Doom4535/ENGR-357-Project/Schematics/CDCE925/PW0016A.stp

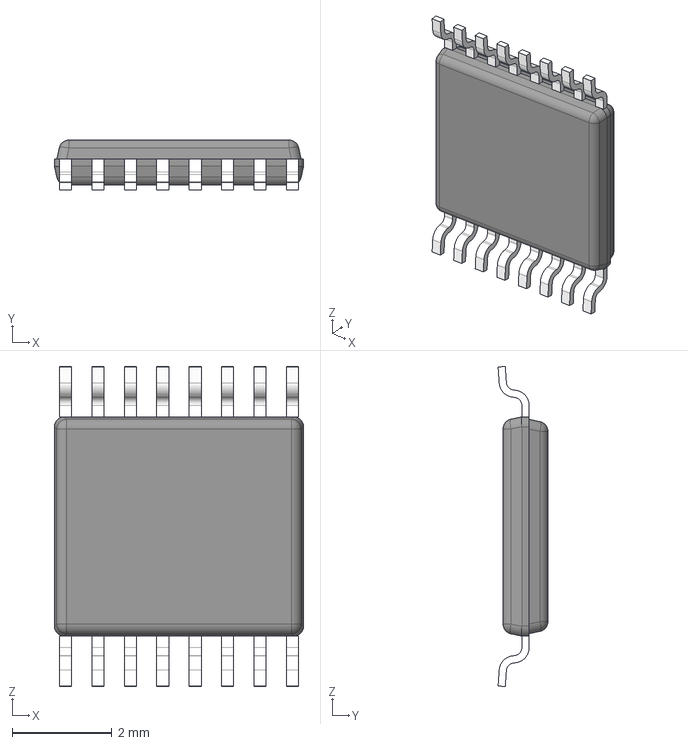
[picture p1: CAD file, 2016-04-19]
Schematics/CDCE925/PW0016A.stp
5.00 x 1.00 x 6.42 mm
BODY_MTC16
LEAD_MTC16 x 16
