Doom4535/ENGR-357-Project/Schematics/TS3A5018/D0016A.stp

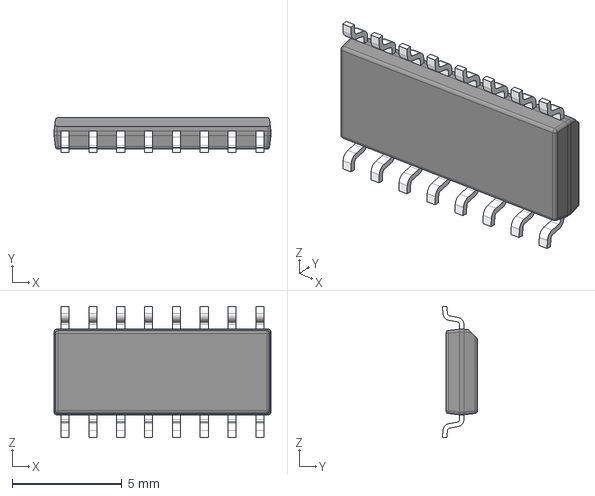
[picture p2: CAD file, 2016-04-19]
Schematics/TS3A5018/D0016A.stp
9.91 x 1.60 x 5.99 mm
BODY_M16A_17
LEAD_M16A_42 x 16
