Doom4535/ENGR-357-Project/PDFs/revised_engr_357.pdf

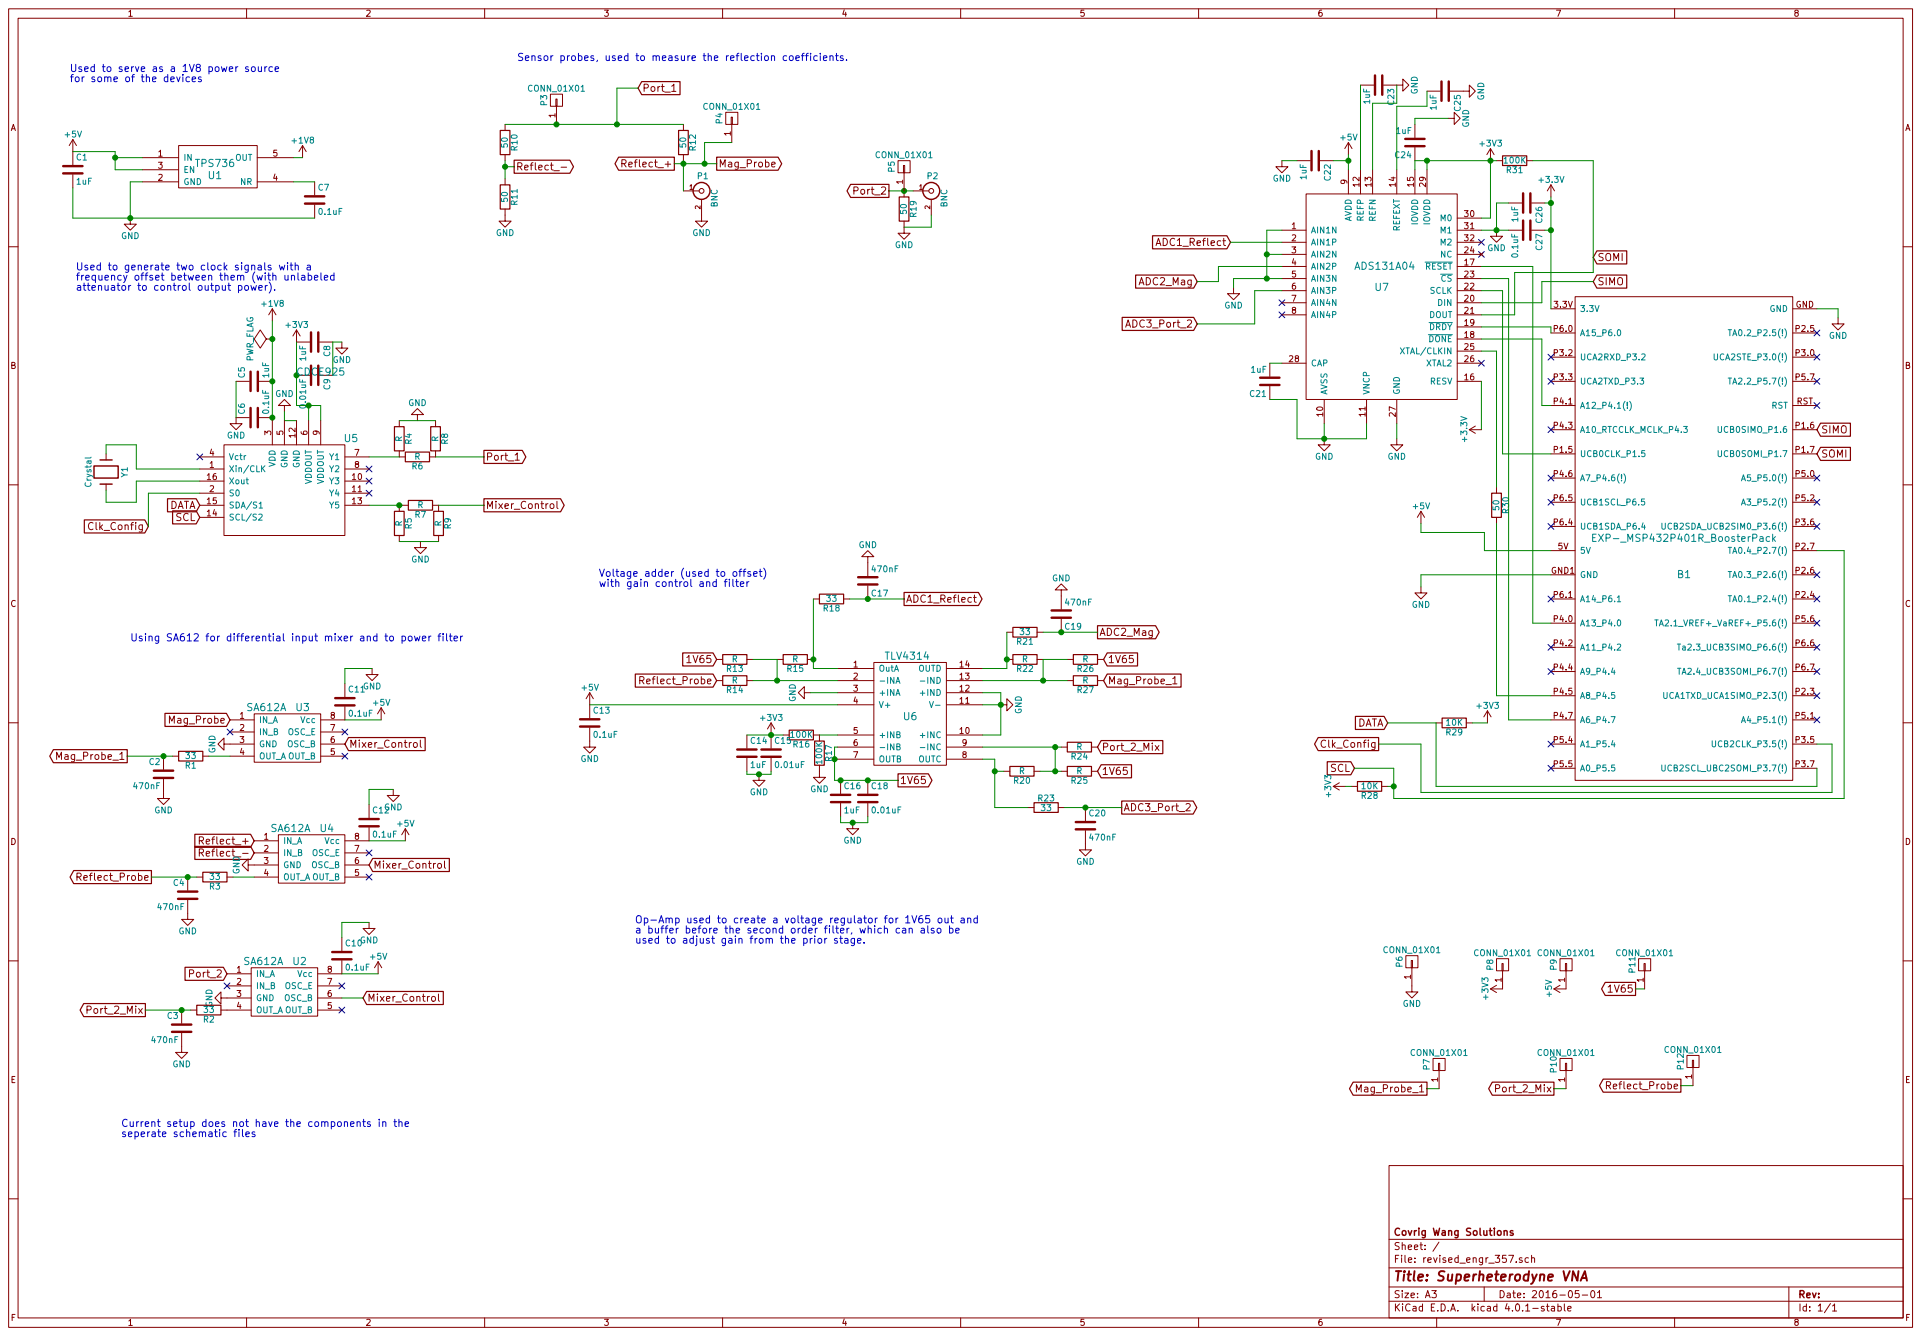
[picture p3: page 1]

Used to serve as a 1V8 power source

9 AVSS 10 DIN 20 M0 30 VNCP 11 DOUT 21 M1 31 REFP 12 SCLK 22 M2 32 REFN 13 CS 23 REFEXT 14 NC 24 IOVDD 15 XTAL/CLKIN 25 RESV 16 XTAL2 26 RESET 17 GND 27 DONE 18 CAP 28 DRDY 19 IOVDD 29 U7 ADS131A04 +3.3V

Used to generate two clock signals with a
frequency offset between them (with unlabeled
attenuator to control output power).

9 Y3 10 Y4 11 GND 12 Y5 13 SCL/S2 14 SDA/S1 15 Xout 16 U5 CDCE925 GND

Using SA612 for differential input mixer and to power filter

1uF Op-Amp used to create a voltage regulator for 1V65 out and

a buffer before the second order filter, which can also be
used to adjust gain from the prior stage.

Current setup does not have the components in the
seperate schematic files

File: revised_engr_357.sch Sheet: / Covrig Wang Solutions

Id: 1/1 Title: Superheterodyne VNA
