Doom4535/ENGR-357-Project/PDFs/VNA.pdf

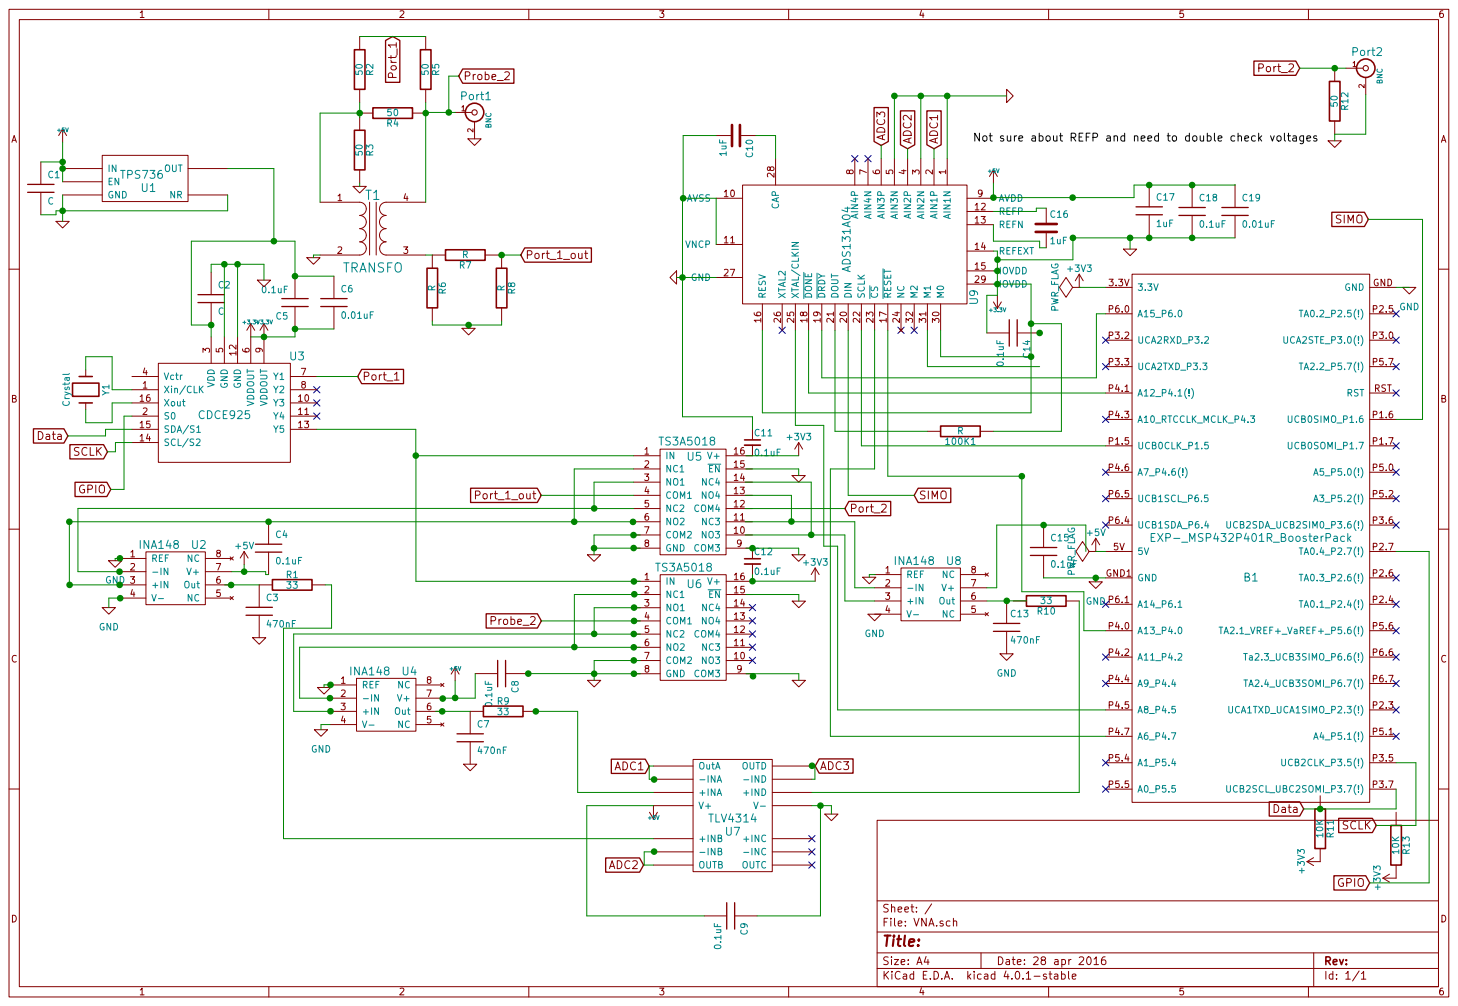
[picture p4: page 1]

8 AVDD 9 AVSS 10 DIN 20 M0 30 VNCP 11 DOUT 21 M1 31 REFP 12 SCLK 22 M2 32 REFN 13 CS 23 REFEXT 14 NC 24

9 Y3 10 Y4 11 GND 12 Y5 13 SCL/S2 14 SDA/S1 15 Xout 16 U3 CDCE925

Id: 1/1 Title: File: VNA.sch Sheet: /
