Doom4535/ENGR-357-Project/(list of files, drawings)

Other design files:
Project_2/revised_engr_357.dsn
