Doom4535/ENGR-357-Project/Project_2/revised_engr_357.kicad_pcb

## KiCad design Project_2/revised_engr_357.kicad_pcb (2016-06-07)

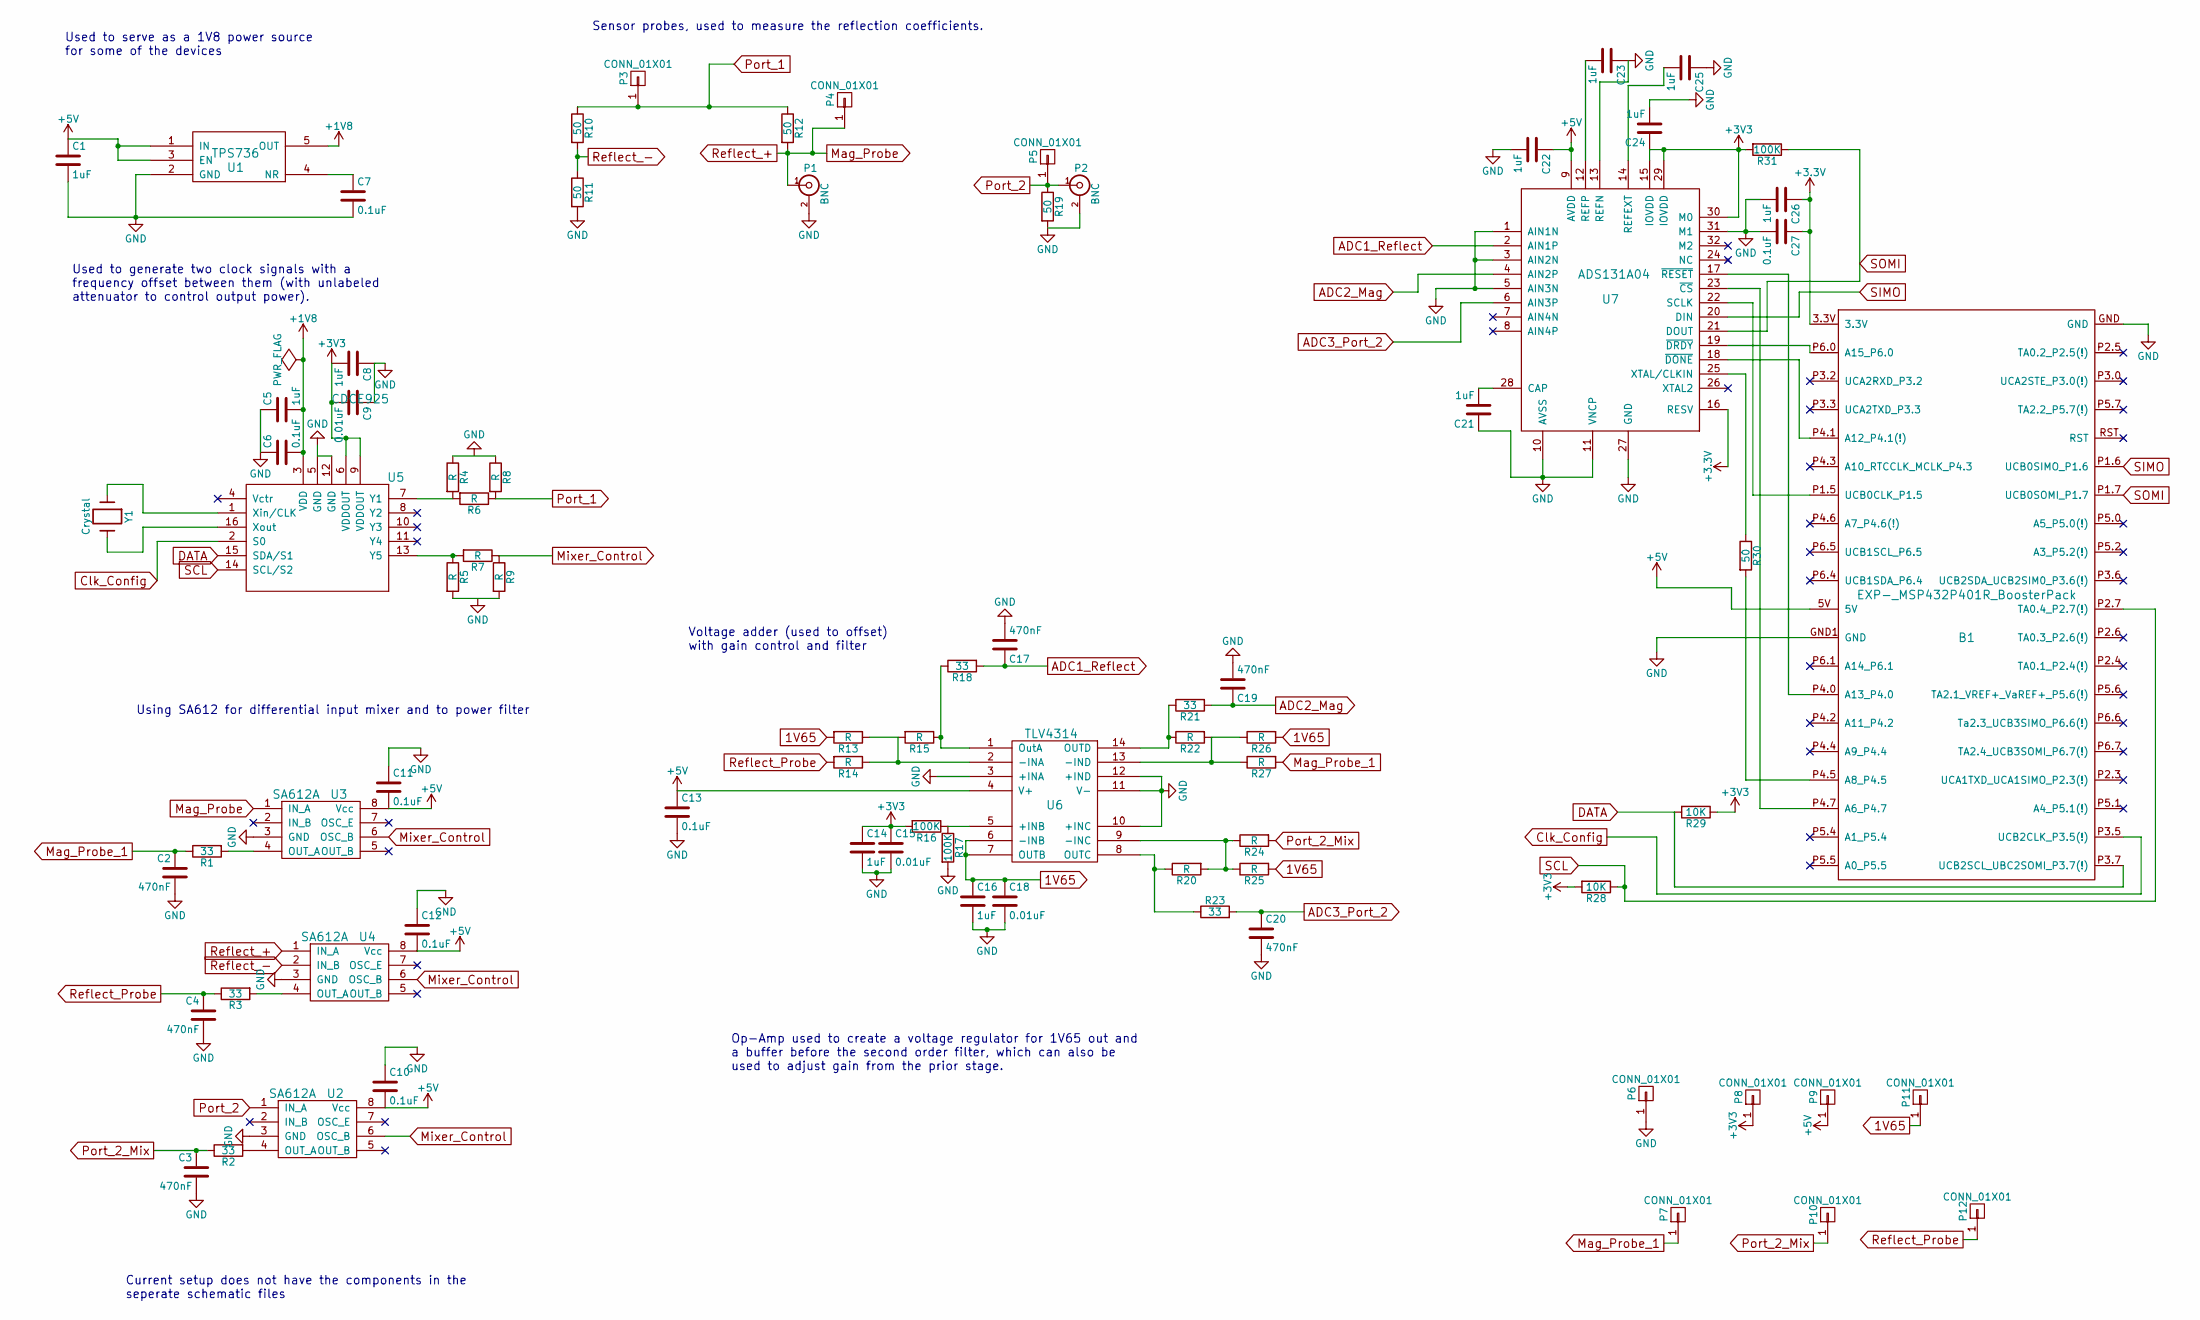
[picture p5: schematic revised_engr_357.sch, Superheterodyne VNA]

Parts:
B1: EXP-_MSP432P401R_BoosterPack; TI_BoosterPack
C1, C5, C8, C14, C16, C21, C22, C23, C24, C25, C26: 1uF; C_0805
C2, C3, C4, C17, C19, C20: 470nF; C_0805
C6, C7, C10, C11, C12, C13, C27: 0.1uF; C_0805
C9, C15, C18: 0.01uF; C_0805
P1, P2: BNC; BNC_Socket_TYCO-AMP
P3, P4, P5, P6, P7, P8, P9, P10, P11, P12: CONN_01X01; Measurement_Point_Round-SMD-Pad_Small
R1, R2, R3, R18, R21, R23: 33; R_0805
R4, R5, R6, R7, R8, R9, R13, R14, R15, R20, R22, R24, R25, R26, R27: R; R_0805
R10, R11, R12, R19, R30: 50; R_0805
R16, R17, R31: 100K; R_0805
R28, R29: 10K; R_0805
U1: TPS736; SOT-23-5
U2, U3, U4: SA612A; SO-8
U5: CDCE925; TSSOP-16_4.4x5mm_Pitch0.65mm
U6: TLV4314; TSSOP-14_4.4x5mm_Pitch0.65mm
U7: ADS131A04; LQFP-32_5x5mm_Pitch0.5mm
Y1: Crystal; Crystal_SMD_2520_4Pads

Connections:
1V65: C16.1, C18.1, P11.1, R13.2, R25.2, R26.2, U6.6 (-INB), U6.7 (OUTB)
+1V8: C5.2, C6.2, U1.5 (OUT), U5.3 (VDD)
+5V: B1.5V, C1.1, C10.2, C11.2, C12.2, C13.1, C22.1, P9.1, U1.1 (IN), U1.3 (EN), U2.8 (Vcc), U3.8 (Vcc), U4.8 (Vcc), U6.4 (V+), U7.9 (AVDD)
ADC1_Reflect: C17.1, R18.2, U7.2 (AIN1P)
ADC2_Mag: C19.1, R21.2, U7.4 (AIN2P)
ADC3_Port_2: C20.1, R23.2, U7.6 (AIN3P)
Clk_Config: B1.P3.5 (UCB2CLK_P3.5(!)), U5.2 (S0)
DATA: B1.P3.7 (UCB2SCL_UBC2SOMI_P3.7(!)), R29.2, U5.15 (SDA/S1)
Mag_Probe: P1.1 (In), P4.1, R12.2, U3.1 (IN_A), U4.1 (IN_A)
Mag_Probe_1: C2.1, P7.1, R1.1, R27.2
Mixer_Control: R7.1, R9.1, U2.6 (OSC_B), U3.6 (OSC_B), U4.6 (OSC_B)
unnamed: B1.P1.5 (UCB0CLK_P1.5), U7.22 (SCLK)
unnamed: B1.P4.0 (A13_P4.0), U7.17 (~RESET)
unnamed: B1.P4.1 (A12_P4.1(!)), U7.18 (~DONE)
unnamed: B1.P4.5 (A8_P4.5), R30.2
unnamed: B1.P4.7 (A6_P4.7), U7.23 (~CS)
unnamed: B1.P6.0 (A15_P6.0), U7.19 (~DRDY)
unnamed: C7.1, U1.4 (NR)
unnamed: C21.2, U7.28 (CAP)
unnamed: C23.2, U7.12 (REFP)
unnamed: C25.2, U7.14 (REFEXT)
unnamed: R1.2, U3.4 (OUT_A)
unnamed: R2.2, U2.4 (OUT_A)
unnamed: R3.2, U4.4 (OUT_A)
unnamed: R4.2, R6.2, U5.7 (Y1)
unnamed: R5.1, R7.2, U5.13 (Y5)
unnamed: R13.1, R14.1, R15.2, U6.2 (-INA)
unnamed: R15.1, R18.1, U6.1 (OutA)
unnamed: R16.1, R17.1, U6.5 (+INB)
unnamed: R20.1, R23.1, U6.8 (OUTC)
unnamed: R20.2, R24.1, R25.1, U6.9 (-INC)
unnamed: R21.1, R22.1, U6.14 (OUTD)
unnamed: R22.2, R26.1, R27.1, U6.13 (-IND)
unnamed: R30.1, U7.25 (XTAL/CLKIN)
unnamed: U5.1 (Xin/CLK), Y1.1
unnamed: U5.16 (Xout), Y1.2
Port_1: P3.1, R6.1, R8.2, R10.1, R12.1
Port_2: P2.1 (In), P5.1, R19.1, U2.1 (IN_A)
Port_2_Mix: C3.1, P10.1, R2.1, R24.2
Reflect_-: R10.2, R11.1, U4.2 (IN_B)
Reflect_Probe: C4.1, P12.1, R3.1, R14.2
SCL: B1.P2.7 (TA0.4_P2.7(!)), R28.1, U5.14 (SCL/S2)
SIMO: B1.P1.6 (UCB0SIMO_P1.6), U7.20 (DIN)
SOMI: B1.P1.7 (UCB0SOMI_P1.7), R31.1, U7.21 (DOUT)

Notes on the sheet:
Op-Amp used to create a voltage regulator for 1V65 out and a buffer before the second order filter, which can also be used to adjust gain from the prior stage.
Using SA612 for differential input mixer and to power filter
Used to generate two clock signals with a frequency offset between them (with unlabeled attenuator to control output power).
Used to serve as a 1V8 power source for some of the devices
Sensor probes, used to measure the reflection coefficients.
Current setup does not have the components in the seperate schematic files
Voltage adder (used to offset) with gain control and filter

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
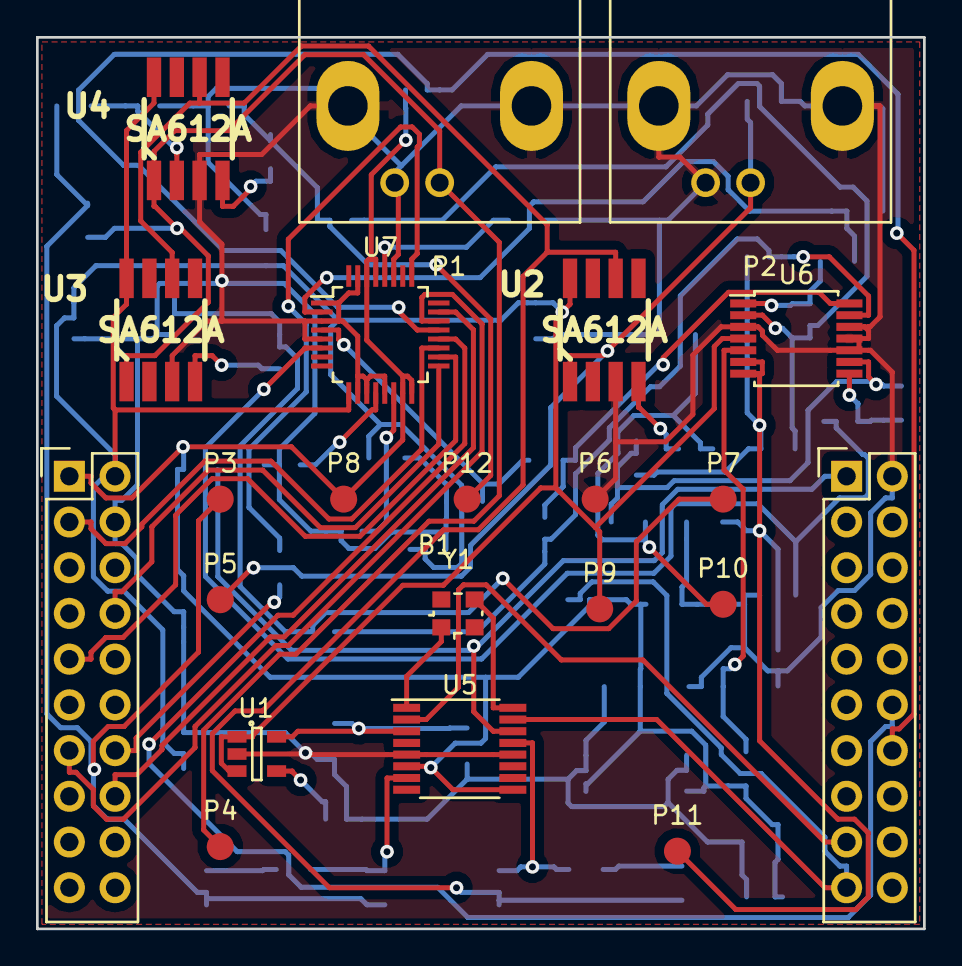
[picture p6: board revised_engr_357.kicad_pcb from above]

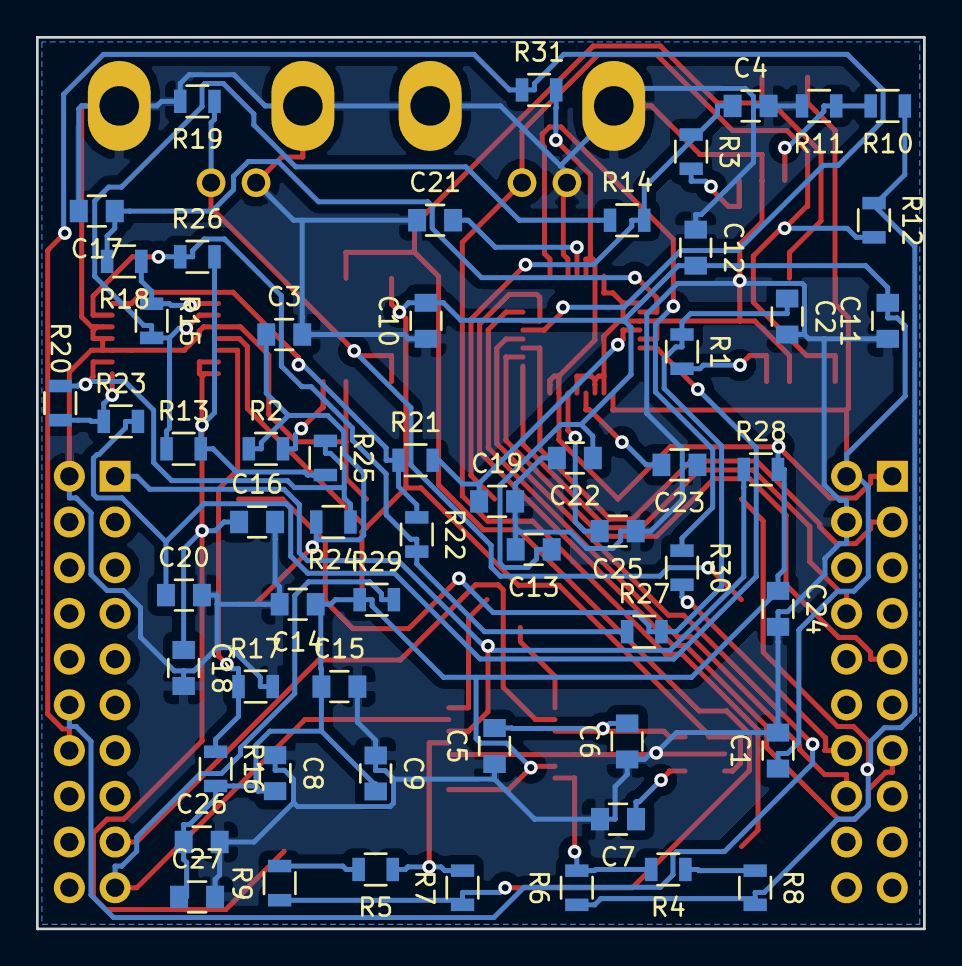
[picture p7: board revised_engr_357.kicad_pcb from below]

Board: 2 copper layers, 49.3 x 49.5 mm, 79 parts (58 on the bottom side), 48 nets.
