Doom4535/ENGR-357-Project/Schematics/content/enforced/279243-ENGR357-S16/2016_VNA.kicad_pcb

## KiCad design Schematics/content/enforced/279243-ENGR357-S16/2016_VNA.kicad_pcb (2016-04-29)

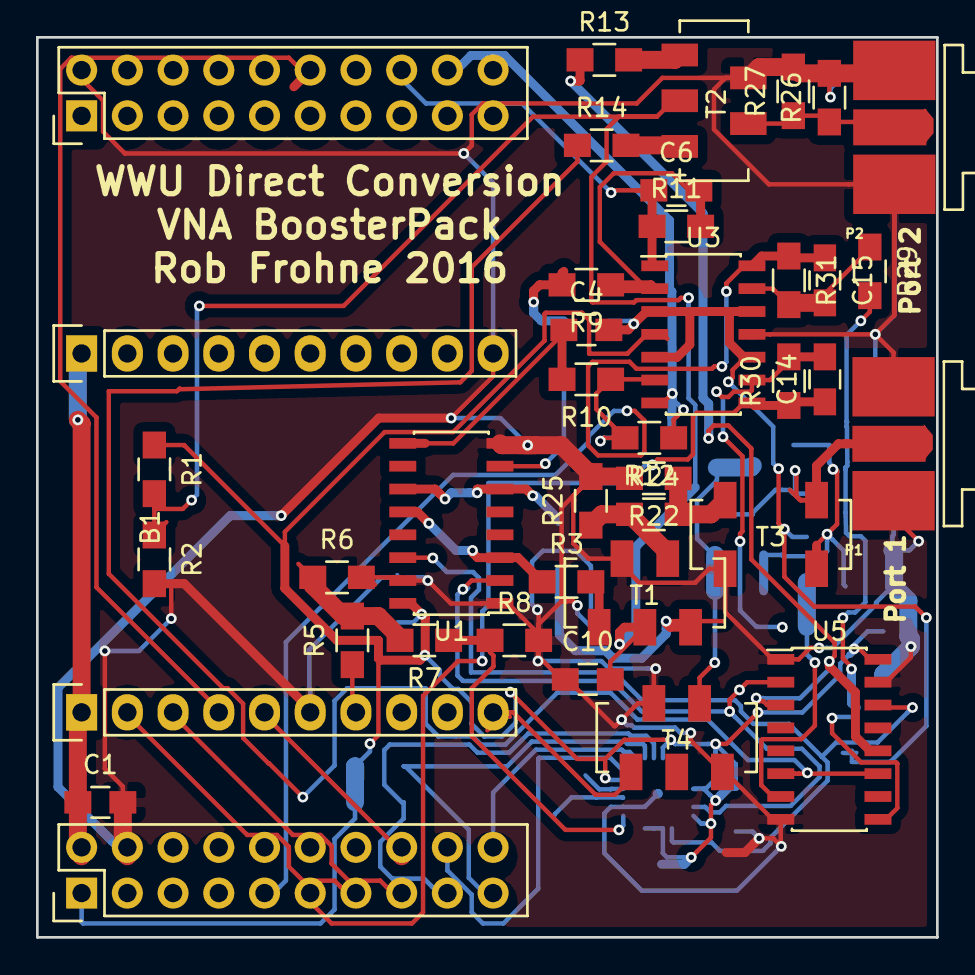
[picture p8: board 2016_VNA.kicad_pcb from above]

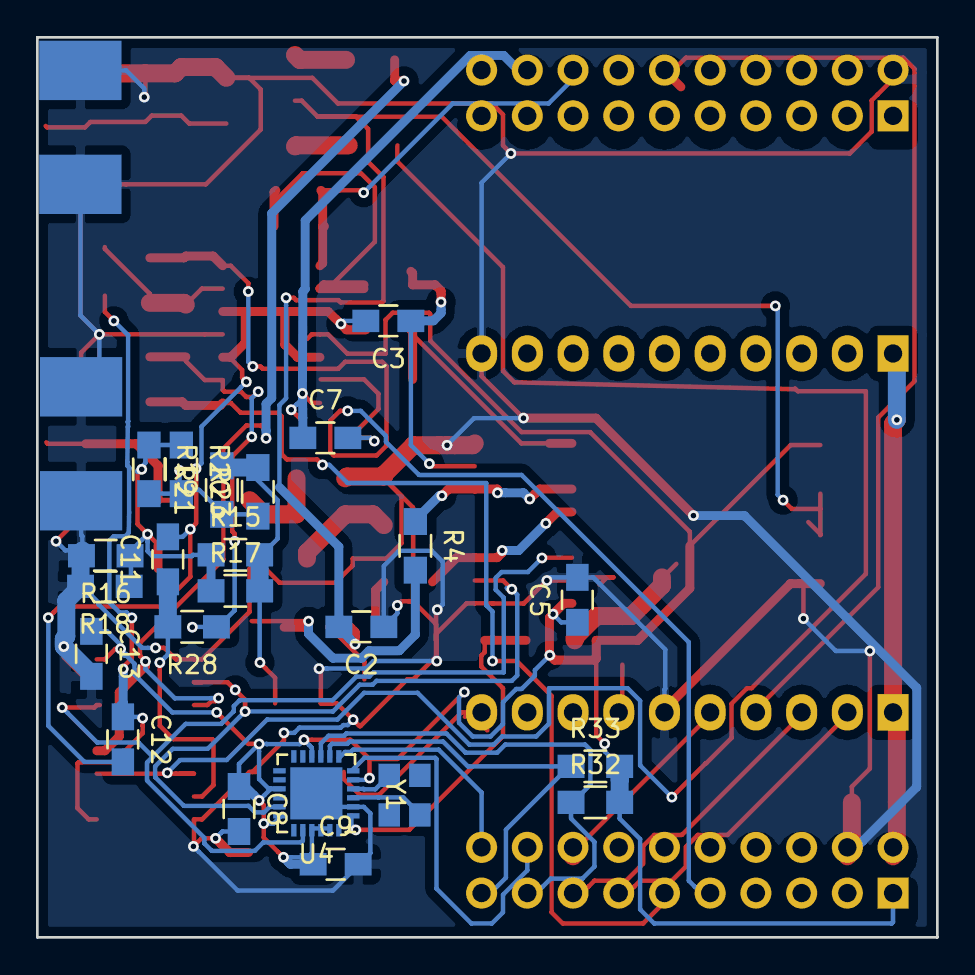
[picture p9: board 2016_VNA.kicad_pcb from below]

Board: 2 copper layers, 50.0 x 50.0 mm, 61 parts (23 on the bottom side), 47 nets.

Parts:
B1: EXP-_MSP432P401R_BoosterPack; TI_BoosterPack
C1, C2, C3, C4, C10, C11, C12: 0.1uF; C_0805_HandSoldering
C5, C13: 1.0uF; C_0805_HandSoldering
C6: 0.01 uF; C_0805_HandSoldering
C7, C14, C15: 0.01uF; C_0805_HandSoldering
C8, C9: 1.0 uF; C_0805_HandSoldering
P1, P2: BNC; SMA_EDGE
R1, R2: 2.2K; R_0805_HandSoldering
R3, R4, R13, R14: 1; R_0805_HandSoldering
R5, R7: 51; R_0805_HandSoldering
R6: 120; R_0805_HandSoldering
R8: 36; R_0805_HandSoldering
R9, R22, R24, R25, R28: R; R_0805_HandSoldering
R10, R29: 10; R_0805_HandSoldering
R11, R12, R30, R31: 4.7K; R_0805_HandSoldering
R15, R16, R17, R18, R19, R20, R21, R23, R26, R27: 100; R_0805_HandSoldering
R32, R33: 10K; R_0805_HandSoldering
T1, T2: 50:200 ohm; 4_to_1_Transmission_Line_Transformer
T3: Balun; 1_to_1_Balun
T4: 4:1 (Z); 4_to_1_Transmission_Line_Transformer
U1, U5: TS3A5017; SOIC-16_3.9x9.9mm_Pitch1.27mm
U2: HC-SR08_DDS_Module
U3: LMV324; SOIC-14_3.9x8.7mm_Pitch1.27mm
U4: 5P49V5923; NLG24_4x4mm_Pitch0.5mm
Y1: Xtal; JA4

Connections:
1.65: C3.2, C4.2, C11.2, C12.2, U3.3, U3.5, U3.10, U3.12
1.65V: C2.2, C10.2, R1.2, R2.1, T1.2, T2.2
4XF_I: U1.14, U4.20, U5.14
4XF_Q: U1.2, U4.17, U5.2
+3V3: B1.3.3V, C5.1, C8.1, C9.1, C13.1, R1.1, R32.2, R33.2, U1.16, U3.4, U4.5, U4.10, U4.15, U4.18, U4.21, U4.22, U4.23, U5.16
+5V: B1.5V, C1.1, U2.J2-1, U2.J4-1
CKSEL: B1.P5.4, U4.6
DDS_RST: B1.P4.7, U2.J4-5
FQ_UD: B1.P4.6, U2.J4-3
F_SINE: T4.3, U2.J410
GND: B1.GND, B1.GND1, C1.2, C2.1, C5.2, C8.2, C9.2, C10.1, C13.2, P1.2, P2.2, R2.2, R6.2, R8.2, R16.2, R18.2, R22.2, R25.2, R26.2, R27.2, T1.5, T2.5, T3.3, T4.1, T4.5, U1.1, U1.8, U1.15, U2.J4-6, U2.J210, U3.11, U4.2, U4.EPAD, U5.1, U5.8, U5.15
MO: B1.P1.6, U2.J4-4
unnamed: C3.1, R9.2, U1.7
unnamed: C4.1, R10.2, U1.9
unnamed: C6.2, R9.1, R11.2, U3.2
unnamed: C7.2, R10.1, R12.2, U3.6
unnamed: C11.1, R28.2, U5.7
unnamed: C12.1, R29.2, U5.9
unnamed: C14.2, R28.1, R30.2, U3.9
unnamed: C15.2, R29.1, R31.2, U3.13
unnamed: P1.1, R19.2, R20.2, R21.1, R23.1, T3.2
unnamed: R3.1, U1.3, U1.12
unnamed: R3.2, T1.3
unnamed: R4.1, U1.6, U1.11
unnamed: R4.2, T1.1
unnamed: R5.1, U2.J4-7
unnamed: R5.2, R6.1, R7.2
unnamed: R7.1, R8.1, U4.1
unnamed: R13.1, U5.3, U5.12
unnamed: R13.2, T2.3
unnamed: R14.1, U5.6, U5.11
unnamed: R14.2, T2.1
unnamed: R15.1, R16.1, R17.1, R18.1, R19.1, R20.1, T3.1
unnamed: R15.2, R17.2, R21.2, R23.2, T4.4
unnamed: R22.1, R24.2, T3.4
unnamed: U4.3, Y1.1
unnamed: U4.4, Y1.2
S11: R24.1, R25.1, T1.4
S11_I: B1.P5.0, C6.1, R11.1, U3.1
S11_Q: B1.P5.2, C7.1, R12.1, U3.7
S21: P2.1, R26.1, R27.1, T2.4
S21_I: B1.P4.3, C14.1, R30.1, U3.8
S21_Q: B1.P4.1, C15.1, R31.1, U3.14
SCL: B1.P6.5, R32.1, U4.9
SCLK: B1.P1.5, U2.J4-2
SD: B1.P5.5, U4.7
SDA: B1.P6.4, R33.1, U4.8
