Doom4535/ENGR-357-Project/(threads)

Thread 1 (2016-04-20):

Find a TI voltage regulator

Doom4535, 2016-04-20:
Needs to be able to take 3V3 or 5V in and put out 1V8 (will want to verify the operating voltages for the rest of the chips, should only need 1V8 since the rest is regulated from the MSP board).  Prefer a linear regulator because of the limited operating noise.
89fa438fbd77766bb7da3003b9e8b8ef4e889d7b

Doom4535, 2016-04-28:
Fixed in 365c24920547c2664f059092988e85cfc33c574a the chosen regulator is the TPS73618 (1V8 model of the TPS736 family).

Closed 2016-04-28.

Thread 4 (2016-04-26):

Improve low-pass filter

Doom4535, 2016-04-26:
As of 8eda11f4ecfd0399c1a9abef5f9bef2558b735ce the VNA still uses only a first order low-pass filter, needs to be updated to a second order at some point.

Doom4535, 2016-04-28:
This is in progress in the dev-doom branch and was started in: 82b7f2498b33e5a87a2911abfc9e2b27203cbabc

Doom4535, 2016-04-30:
Fixed in 653395da86e79ca4e1ccd50e58c18530f9c51217 (corrected orientation and verified 2nd order setup).

Closed 2016-04-30.

Thread 6 (2016-04-26):

Pull up resistors

Doom4535, 2016-04-26:
Needs a pull up resistor on the ADC and possibly clock (check datasheets)

Doom4535, 2016-04-27:
Put one on both the SDA and SCL pins around the clock f0fd1d4e4ff8be3700cdf6a2b7803d761d38e12e although leaving open because I have not verified on the ADC

Doom4535, 2016-04-30:
Fixed in 653395da86e79ca4e1ccd50e58c18530f9c51217

Closed 2016-04-30.
