Doom4535/ENGR-357-Project/(commit log)

2016-04-19 Updating to fix broken diagrams
    [VNA.sch]
2016-04-20 Adding in additional library for the crystal that may be used and adding in some additional connections.
    [VNA.sch]
2016-04-20 Adding in header pins for the MSP432 to a seperate library and moving some wiring
    [VNA.sch]
2016-04-20 Adding in simple voltage divider till a regulator can be decided on (preferably from TI), also added some power connections
    [VNA.sch]
2016-04-22 Adding in class libraries, extract the MSP432 library and change to using it instead of the current one
2016-04-22 This closes #2 and adds a few wires
    [VNA.sch]
2016-04-25 Fixing flipped pins on the ADC
    [VNA.sch]
2016-04-25 added voltage regulator
    [VNA.sch]
2016-04-26 Updating, starting probes
    [VNA.sch]
2016-04-26 adding in bypass capacitors
    [VNA.sch]
2016-04-26 adding more component values
    [VNA.sch]
2016-04-26 saving before converting probes to work with reflection coefficient
    [VNA.sch]
2016-04-26 converted first probe to use reflection coefficient
    [VNA.sch]
2016-04-26 updated to use s-parameters (reflection coefficients) still uses only a first order low-pass filter (need to update to a second order)
    [VNA.sch]
2016-04-27 Adding in two pullup resistors and the 3rd probe, also attached several datasheets
    [VNA.sch]
2016-04-28 probe fixed
    [VNA.sch]
2016-04-28 adding in export and renamed a flag
    [VNA.sch]
2016-04-28 Adding in second version of project with better organized schematic
    [revised_engr_357.kicad_pcb, revised_engr_357.sch]
2016-04-28 moving some folders around and performing minor housekeeping
    [VNA.kicad_pcb, VNA.sch]
2016-04-29 Finishing v2 of the schematic
    [2016_VNA.kicad_pcb, revised_engr_357.sch]
2016-04-29 adding in pull up resistors
    [revised_engr_357.sch]
2016-04-29 added in resistor on clock source to ADC
    [revised_engr_357.sch]
2016-04-29 updating libraries to relative paths
    [revised_engr_357.sch]
2016-04-30 updating design, fixed low-pass filters, ect
    [revised_engr_357.sch]
2016-05-01 fixing voltage offset of transformer and adding in a 1V65 source
    [revised_engr_357.sch]
2016-05-02 adding in AVdd reference to the differential amps
    [revised_engr_357.sch]
2016-05-02 deleted random ground off page
    [revised_engr_357.sch]
2016-05-02 cleaning up schematic layout
    [1V8_power.sch, diff_amp_and_filter.sch, input_mixers.sch, opamp_and_filter.sch, revised_engr_357.sch, system_clock.sch]
2016-05-02 cleaning up some of the layouts and improved voltage regulator
    [1V8_power.sch, diff_amp_and_filter.sch, opamp_and_filter.sch, probes.sch, revised_engr_357.sch, system_clock.sch]
2016-05-04 updating schematic to use new mixer
    [1V8_power.sch, diff_amp_and_filter.sch, input_mixers.sch, opamp_and_filter.sch, probes.sch, revised_engr_357.sch, system_clock.sch]
2016-05-04 finishing new mixers
    [revised_engr_357.sch]
2016-05-06 partial fix
    [revised_engr_357.sch]
2016-05-08 fixed probes, removed third order filter, fixed electrical rules checks
    [revised_engr_357.sch]
2016-05-08 working towards pcb
    [extra.kicad_pcb, revised_engr_357.sch]
2016-05-08 working on adding footprints
    [revised_engr_357.sch]
2016-05-08 starting pcb layout
    [revised_engr_357.kicad_pcb, revised_engr_357.sch]
2016-05-08 fixed some errors and still working on pcb
    [revised_engr_357.kicad_pcb, revised_engr_357.sch]
2016-05-08 working on pcb layout
    [revised_engr_357.kicad_pcb]
2016-05-08 testing different pcb layouts
    [revised_engr_357.kicad_pcb]
2016-05-09 modifying files
    [revised_engr_357.kicad_pcb, revised_engr_357.sch]
2016-05-09 redoing pcb
    [revised_engr_357.kicad_pcb, revised_engr_357.sch]
2016-05-09 uploading pcb without ground plane
    [_saved_revised_engr_357.sch, revised_engr_357.dsn, revised_engr_357.kicad_pcb]
2016-05-09 finished preliminary schematic and pcb
    [1V8_power.sch, _saved_revised_engr_357.sch, diff_amp_and_filter.sch, input_mixers.sch, opamp_and_filter.sch, probes.sch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]
2016-05-09 changning via size and adding test points
    [revised_engr_357-B.Cu.gbr, revised_engr_357-B.Mask.gbr, revised_engr_357-B.Paste.gbr, revised_engr_357-B.SilkS.gbr, revised_engr_357-Edge.Cuts.gbr, revised_engr_357-F.Cu.gbr, revised_engr_357-F.Mask.gbr, revised_engr_357-F.Paste.gbr]
2016-05-09 adding in the ground pours that were forgotten in the previous commit
    [revised_engr_357-B.Cu.gbr, revised_engr_357-B.Mask.gbr, revised_engr_357-B.Paste.gbr, revised_engr_357-B.SilkS.gbr, revised_engr_357-Edge.Cuts.gbr, revised_engr_357-F.Cu.gbr, revised_engr_357-F.Mask.gbr, revised_engr_357-F.Paste.gbr]
2016-05-09 adding in missing footprint library
2016-05-10 additional routing sizes
    [revised_engr_357-B.Cu.gbr, revised_engr_357-B.Mask.gbr, revised_engr_357-B.Paste.gbr, revised_engr_357-B.SilkS.gbr, revised_engr_357-Edge.Cuts.gbr, revised_engr_357-F.Cu.gbr, revised_engr_357-F.Mask.gbr, revised_engr_357-F.Paste.gbr]
2016-05-10 larger via developement branch
    [revised_engr_357.kicad_pcb]
2016-05-11 new enlarged via schematic
    [revised_engr_357.kicad_pcb]
2016-06-07 commiting some past changes
    [revised_engr_357.kicad_pcb]
2016-06-07 adding in test points
    [revised_engr_357.sch]
